truher/power-logger/README.md

# Power Logger

Multichannel logger for residential power consumption measurement.
Reads two legs of 120v and a whole log of inductive current measurements.
Uses interrupts on the Teensy to avoid phase error.
