truher/power-logger/hardware/megamon-sch.png

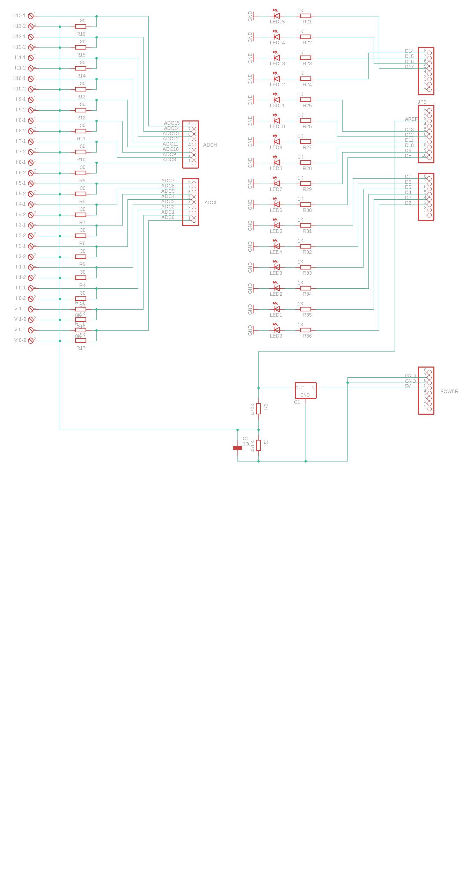
hardware/megamon-sch.png
