truher/power-logger/hardware/teensy/teensy.csv

Id | Designator | Package | Quantity | Designation | Supplier and ref
1 | U1 | Teensy35_36_EMON | 1 | Teensy3.5
2 | R40,R39,R38,R37,R36,R35,R34,R33,R32,R31,R30,R29,R28,R27,R26,R25,R24,R23 | AXIAL-0.3 | 18 | 20K
3 | J6,J5 | 1X02 | 2 | ~
4 | J4,J3,J2,J1 | 1X08 | 4 | ~
5 | RV18,RV17 | Potentiometer_Bourns_3296W_Vertical | 2 | 100K
6 | RV16,RV15,RV14,RV13,RV12,RV11,RV10,RV9,RV8,RV7,RV6,RV5,RV4,RV3,RV2,RV1 | Potentiometer_Bourns_3296W_Vertical | 16 | 200
7 | R18,R17 | AXIAL-0.3 | 2 | 100K
8 | D36,D35,D34,D33,D32,D31,D30,D29,D28,D27,D26,D25,D24,D23,D22,D21,D20,D19,D18,D17,D16,D15,D14,D13,D12,D11,D10,D9,D8,D7,D6,D5,D4,D3,D2,D1 | D_SOD-123 | 36 | ~
