truher/power-logger/hardware/teensy/teensy.kicad_pcb

## KiCad design hardware/teensy/teensy.kicad_pcb (2020-11-08)

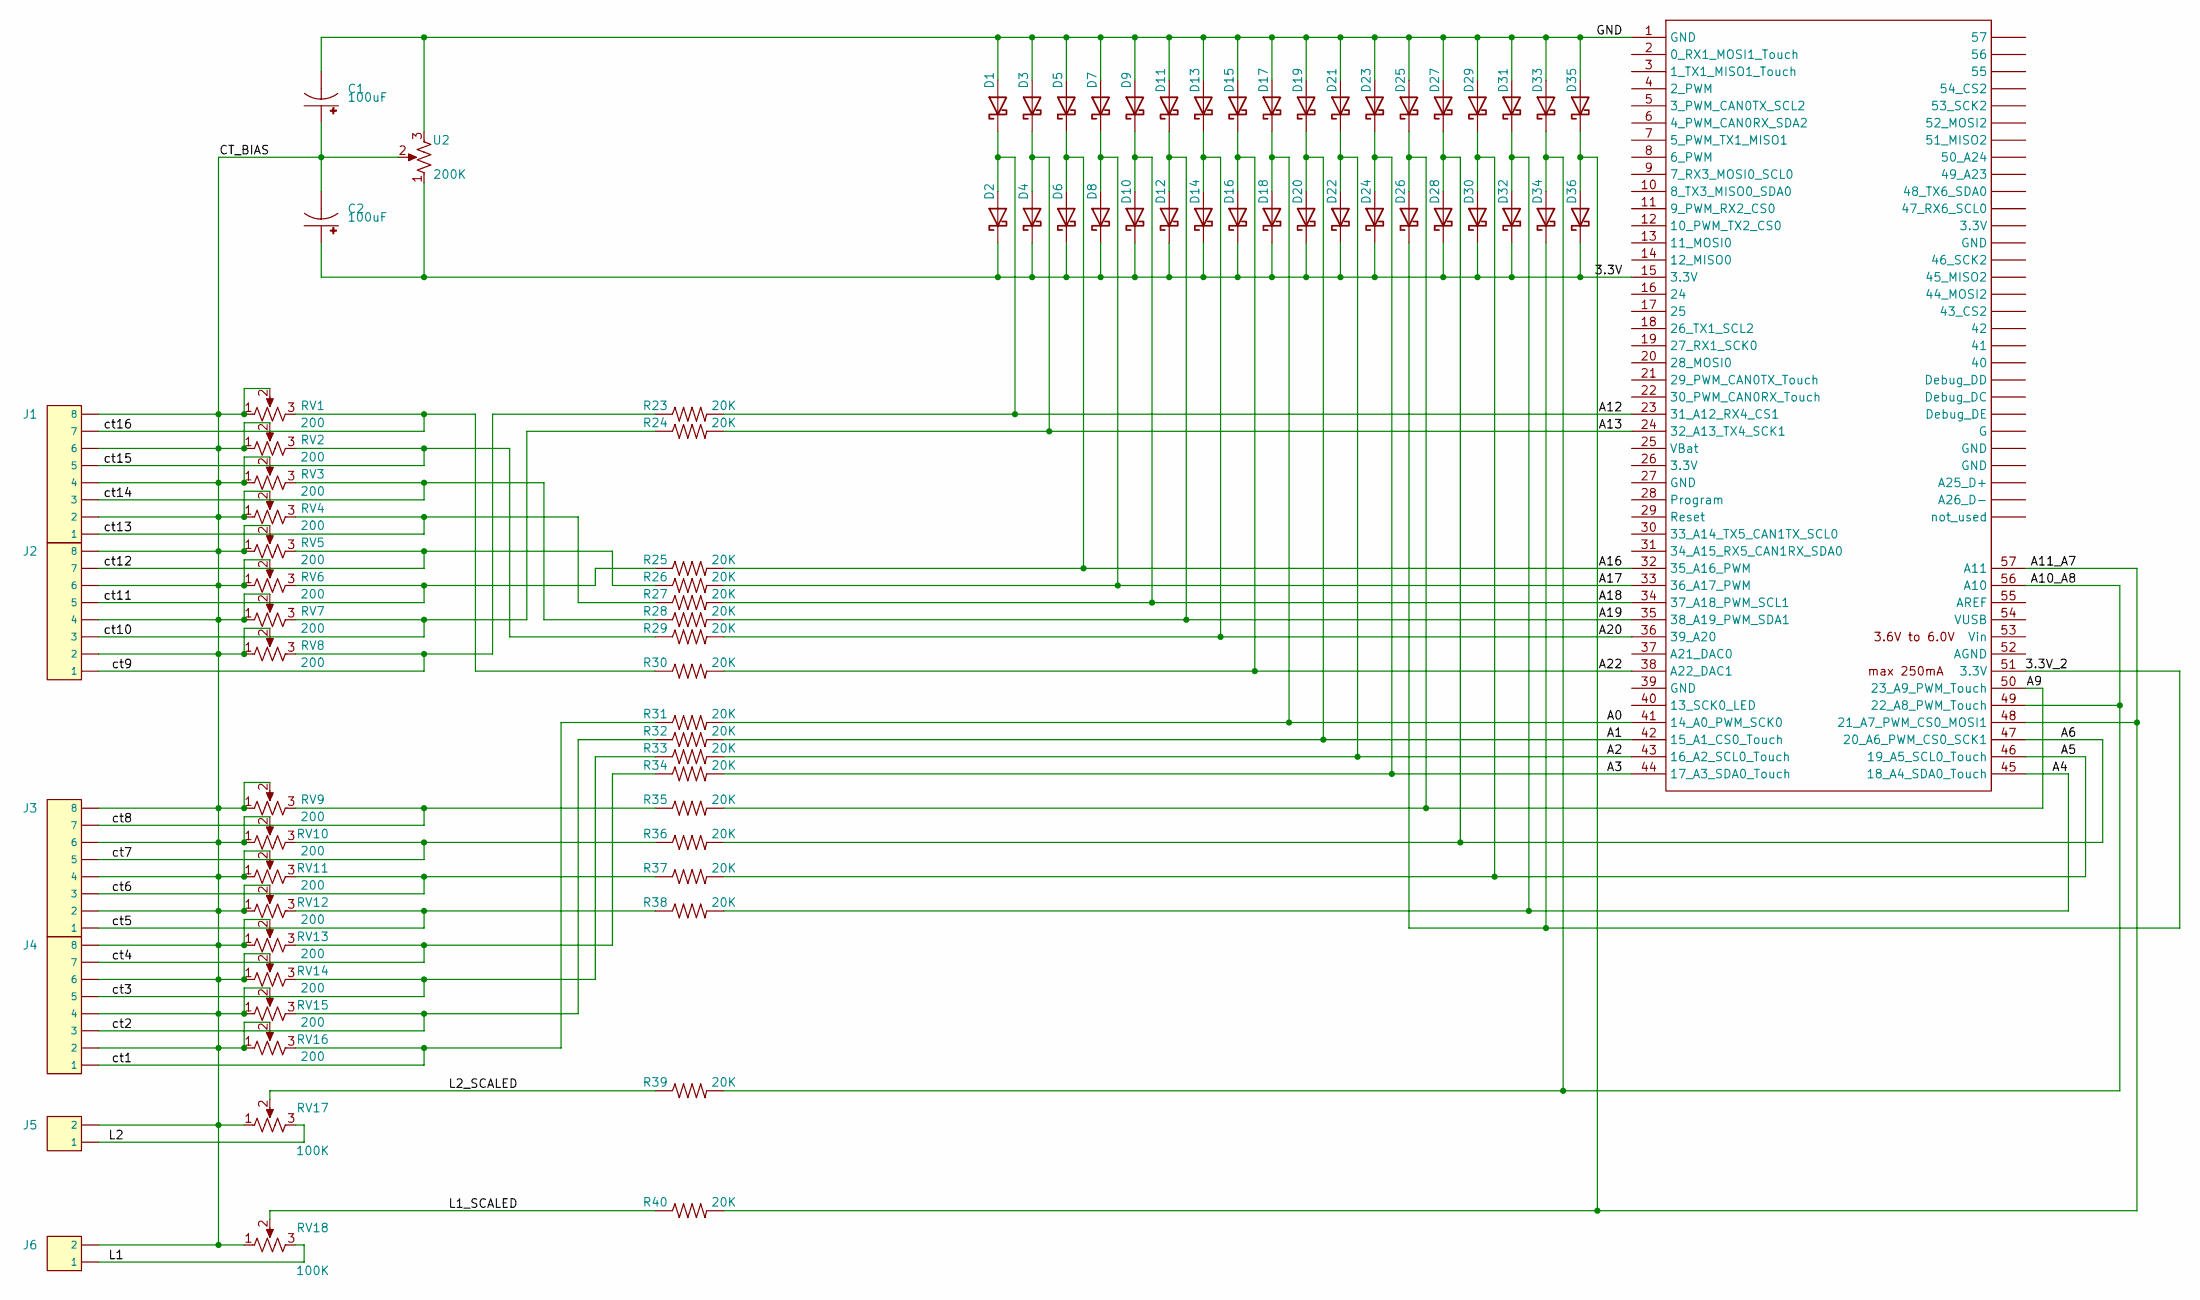
[picture p2: schematic teensy.kicad_sch]

Parts:
C1, C2: 100uF; CPOL-RADIAL-5MM-10MM
D1, D2, D3, D4, D5, D6, D7, D8, D9, D10, D11, D12, D13, D14, D15, D16, D17, D18, D19, D20, D21, D22, D23, D24, D25, D26, D27, D28, D29, D30, D31, D32, D33, D34, D35, D36: D_SOD-123
J1, J2, J3, J4: 1X08
J5, J6: 1X02
R23, R24, R25, R26, R27, R28, R29, R30, R31, R32, R33, R34, R35, R36, R37, R38, R39, R40: 20K; AXIAL-0.3
RV1, RV2, RV3, RV4, RV5, RV6, RV7, RV8, RV9, RV10, RV11, RV12, RV13, RV14, RV15, RV16: 200; Potentiometer_Bourns_3296W_Vertical
RV17, RV18: 100K; Potentiometer_Bourns_3296W_Vertical
U1: Teensy3.5; Teensy35_36_EMON
U2: 200K; Potentiometer_Bourns_3296W_Vertical

Connections:
/3.3V: C2.+, D2.1 (K), D4.1 (K), D6.1 (K), D8.1 (K), D10.1 (K), D12.1 (K), D14.1 (K), D16.1 (K), D18.1 (K), D20.1 (K), D22.1 (K), D24.1 (K), D28.1 (K), D30.1 (K), D32.1 (K), D36.1 (K), U1.15 (3.3V), U2.1
/3.3V_2: D26.1 (K), D34.1 (K), U1.51 (3.3V)
/A0: D17.1 (K), D18.2 (A), R31.P$2 (2), U1.41 (14_A0_PWM_SCK0)
/A1: D19.1 (K), D20.2 (A), R32.P$2 (2), U1.42 (15_A1_CS0_Touch)
/A2: D21.1 (K), D22.2 (A), R33.P$2 (2), U1.43 (16_A2_SCL0_Touch)
/A3: D23.1 (K), D24.2 (A), R34.P$2 (2), U1.44 (17_A3_SDA0_Touch)
/A4: D31.1 (K), D32.2 (A), R38.P$2 (2), U1.45 (18_A4_SDA0_Touch)
/A5: D29.1 (K), D30.2 (A), R37.P$2 (2), U1.46 (19_A5_SCL0_Touch)
/A6: D27.1 (K), D28.2 (A), R36.P$2 (2), U1.47 (20_A6_PWM_CS0_SCK1)
/A9: D25.1 (K), D26.2 (A), R35.P$2 (2), U1.50 (23_A9_PWM_Touch)
/A10_A8: D33.1 (K), D34.2 (A), R39.P$2 (2), U1.49 (22_A8_PWM_Touch), U1.56 (A10)
/A11_A7: D35.1 (K), D36.2 (A), R40.P$2 (2), U1.48 (21_A7_PWM_CS0_MOSI1), U1.57 (A11)
/A12: D1.1 (K), D2.2 (A), R23.P$2 (2), U1.23 (31_A12_RX4_CS1)
/A13: D3.1 (K), D4.2 (A), R24.P$2 (2), U1.24 (32_A13_TX4_SCK1)
/A16: D5.1 (K), D6.2 (A), R25.P$2 (2), U1.32 (35_A16_PWM)
/A17: D7.1 (K), D8.2 (A), R26.P$2 (2), U1.33 (36_A17_PWM)
/A18: D9.1 (K), D10.2 (A), R27.P$2 (2), U1.34 (37_A18_PWM_SCL1)
/A19: D11.1 (K), D12.2 (A), R28.P$2 (2), U1.35 (38_A19_PWM_SDA1)
/A20: D13.1 (K), D14.2 (A), R29.P$2 (2), U1.36 (39_A20)
/A22: D15.1 (K), D16.2 (A), R30.P$2 (2), U1.38 (A22_DAC1)
/CT_BIAS: C1.+, C2.-, J1.2, J1.4, J1.6, J1.8, J2.2, J2.4, J2.6, J2.8, J3.2, J3.4, J3.6, J3.8, J4.2, J4.4, J4.6, J4.8, J5.2, J6.2, RV1.1, RV1.2, RV2.1, RV2.2, RV3.1, RV3.2, RV4.1, RV4.2, RV5.1, RV5.2, RV6.1, RV6.2, RV7.1, RV7.2, RV8.1, RV8.2, RV9.1, RV9.2, RV10.1, RV10.2, RV11.1, RV11.2, RV12.1, RV12.2, RV13.1, RV13.2, RV14.1, RV14.2, RV15.1, RV15.2, RV16.1, RV16.2, RV17.1, RV18.1, U2.2
/GND: C1.-, D1.2 (A), D3.2 (A), D5.2 (A), D7.2 (A), D9.2 (A), D11.2 (A), D13.2 (A), D15.2 (A), D17.2 (A), D19.2 (A), D21.2 (A), D23.2 (A), D25.2 (A), D27.2 (A), D29.2 (A), D31.2 (A), D33.2 (A), D35.2 (A), U1.1 (GND), U2.3
/L1: J6.1, RV18.3
/L1_SCALED: R40.P$1 (1), RV18.2
/L2: J5.1, RV17.3
/L2_SCALED: R39.P$1 (1), RV17.2
/ct1: J4.1, R31.P$1 (1), RV16.3
/ct2: J4.3, R32.P$1 (1), RV15.3
/ct3: J4.5, R33.P$1 (1), RV14.3
/ct4: J4.7, R34.P$1 (1), RV13.3
/ct5: J3.1, R38.P$1 (1), RV12.3
/ct6: J3.3, R37.P$1 (1), RV11.3
/ct7: J3.5, R36.P$1 (1), RV10.3
/ct8: J3.7, R35.P$1 (1), RV9.3
/ct9: J2.1, R23.P$1 (1), RV8.3
/ct10: J2.3, R24.P$1 (1), RV7.3
/ct11: J2.5, R25.P$1 (1), RV6.3
/ct12: J2.7, R26.P$1 (1), RV5.3
/ct13: J1.1, R27.P$1 (1), RV4.3
/ct14: J1.3, R28.P$1 (1), RV3.3
/ct15: J1.5, R29.P$1 (1), RV2.3
/ct16: J1.7, R30.P$1 (1), RV1.3

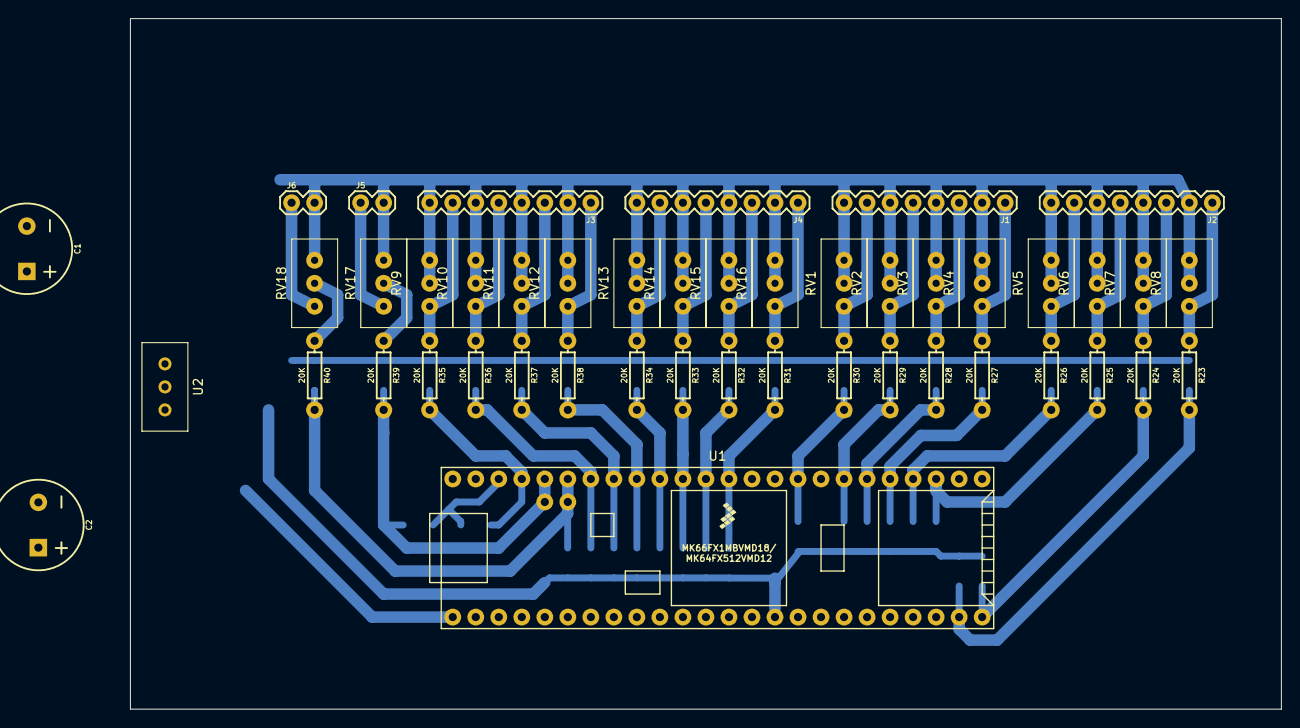
[picture p3: board teensy.kicad_pcb from above]

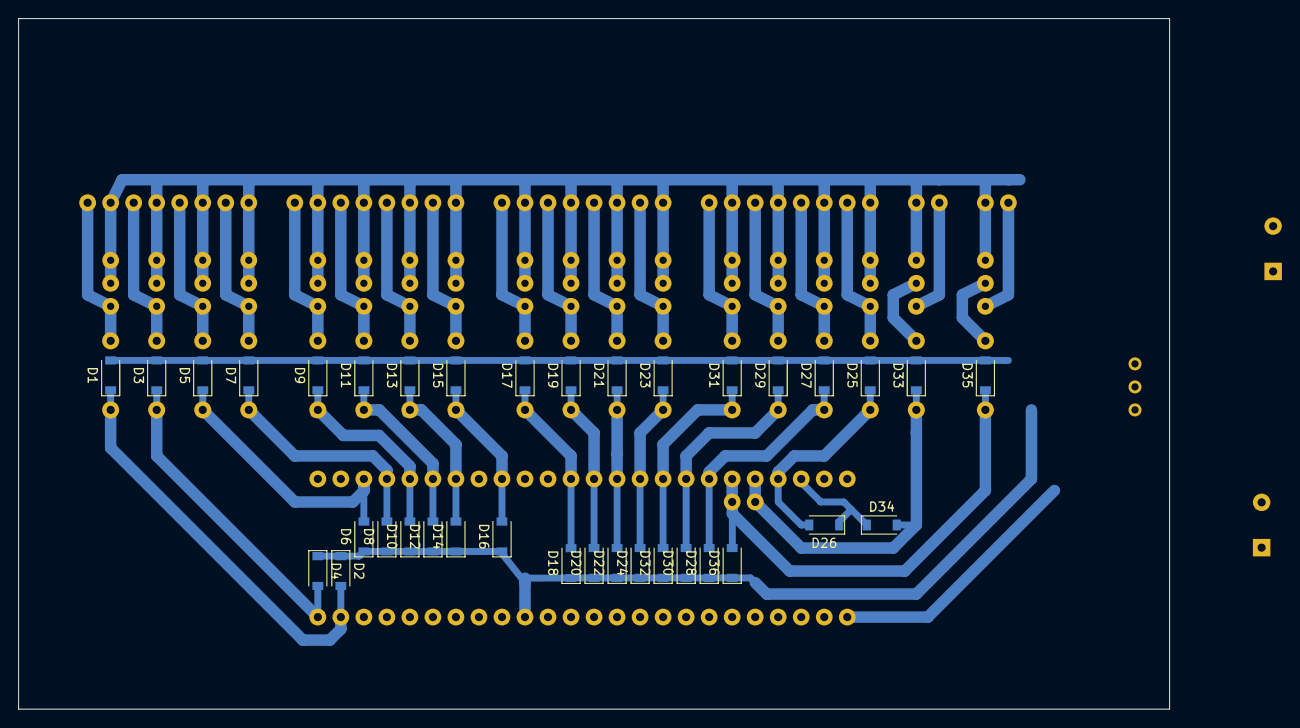
[picture p4: board teensy.kicad_pcb from below]

Board: 2 copper layers, 127.0 x 76.2 mm, 82 parts (36 on the bottom side), 42 nets.
