truher/power-logger/hardware/megamon.brd

## EAGLE design hardware/megamon.brd (2020-06-10)

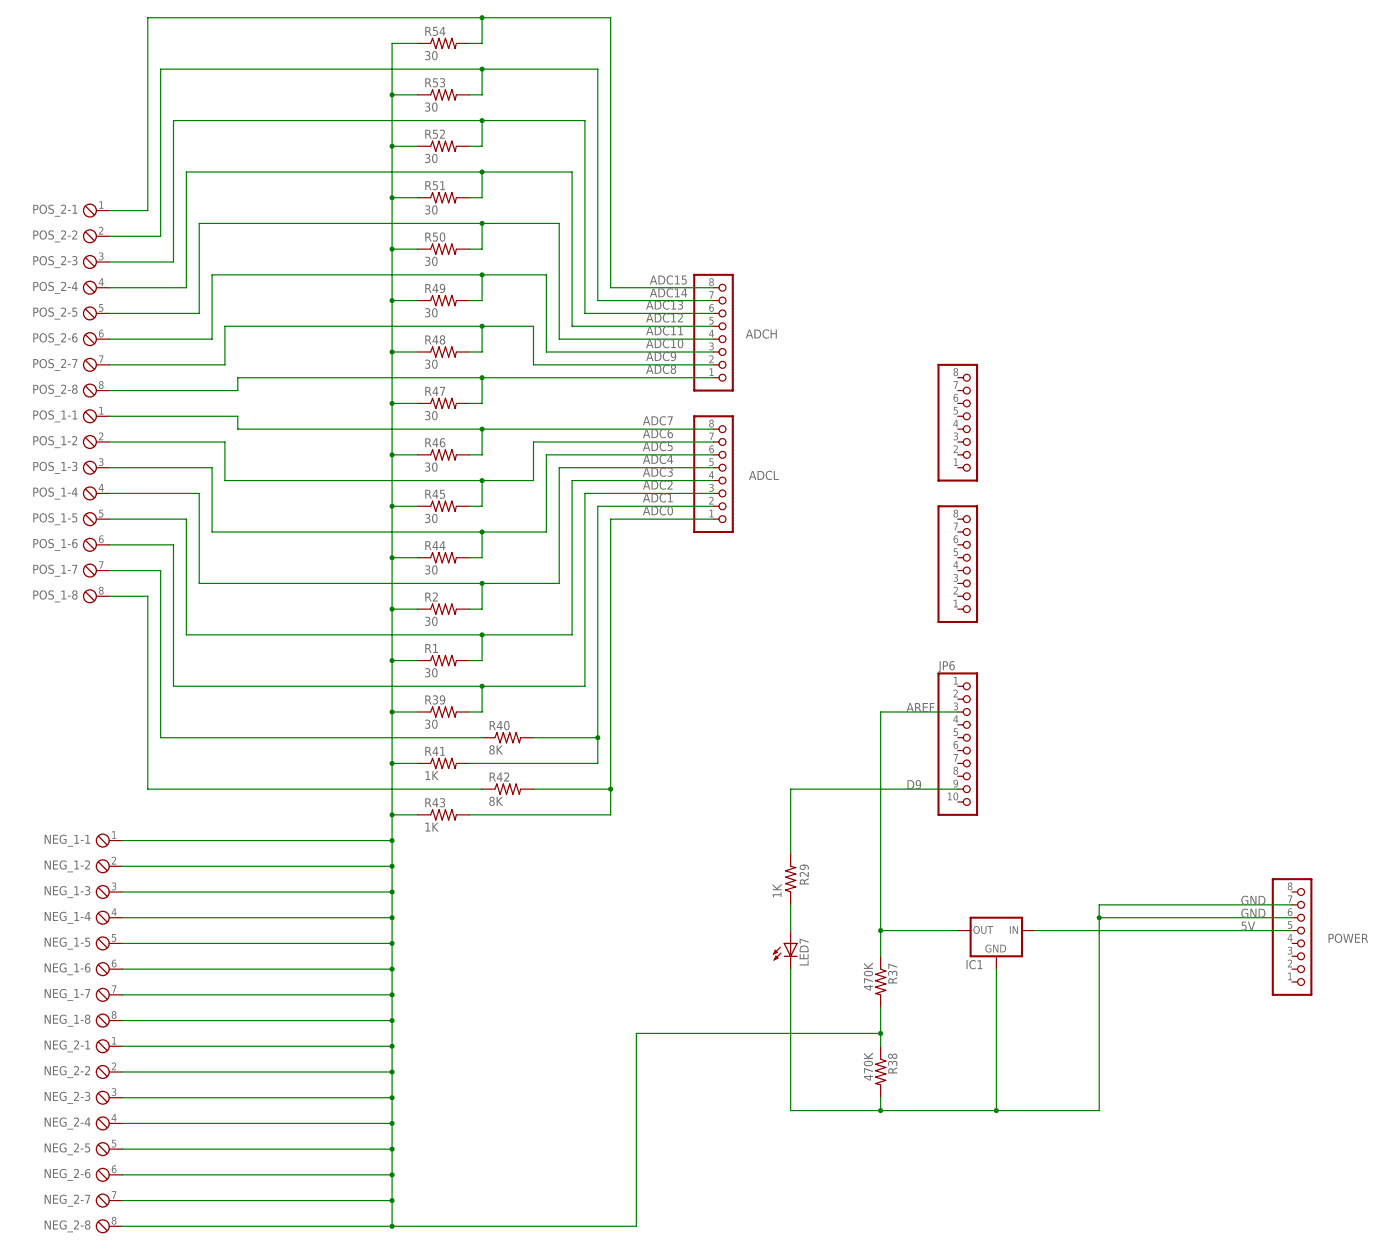
[picture p5: schematic megamon.sch]

Parts:
ADCH: PINHD-1X8; 1X08
ADCL: PINHD-1X8; 1X08
COMMUNICATION: FH254-108DF08500V; 1X08
IC1: MCP1700INLINE; TO92-INLINE
JP6: FH254-110DF08500V; 1X10
LED7: green; LED3MM
NEG_1, NEG_2: MPT8; 8POL254
POS_1, POS_2: MPT8; 8POL254
POWER: PINHD-1X8; 1X08
PWML: FH254-108DF08500V; 1X08
R1, R2, R39, R44, R45, R46, R47, R48, R49, R50, R51, R52, R53, R54: 30; 0204/7
R29, R41, R43: 1K; 0204/7
R37, R38: 470K; 0204/7
R40, R42: 8K; 0204/7

Connections:
5V: IC1.2 (IN), POWER.5
ADC0: ADCL.1, R42.2, R43.2
ADC1: ADCL.2, R40.2, R41.2
ADC2: ADCL.3, POS_1.6, R39.2
ADC3: ADCL.4, POS_1.5, R1.2
ADC4: ADCL.5, POS_1.4, R2.2
ADC5: ADCL.6, POS_1.3, R44.2
ADC6: ADCL.7, POS_1.2, R45.2
ADC7: ADCL.8, POS_1.1, R46.2
ADC8: ADCH.1, POS_2.8, R47.2
ADC9: ADCH.2, POS_2.7, R48.2
ADC10: ADCH.3, POS_2.6, R49.2
ADC11: ADCH.4, POS_2.5, R50.2
ADC12: ADCH.5, POS_2.4, R51.2
ADC13: ADCH.6, POS_2.3, R52.2
ADC14: ADCH.7, POS_2.2, R53.2
ADC15: ADCH.8, POS_2.1, R54.2
AREF: IC1.3 (OUT), JP6.3, R37.1
D9: JP6.9, R29.2
GND: IC1.1 (GND), LED7.K (C), POWER.6, POWER.7, R38.2
unnamed: POS_1.7, R40.1
unnamed: POS_1.8, R42.1
unnamed: LED7.A, R29.1
V_MID: NEG_1.1, NEG_1.2, NEG_1.3, NEG_1.4, NEG_1.5, NEG_1.6, NEG_1.7, NEG_1.8, NEG_2.1, NEG_2.2, NEG_2.3, NEG_2.4, NEG_2.5, NEG_2.6, NEG_2.7, NEG_2.8, R1.1, R2.1, R37.2, R38.1, R39.1, R41.1, R43.1, R44.1, R45.1, R46.1, R47.1, R48.1, R49.1, R50.1, R51.1, R52.1, R53.1, R54.1

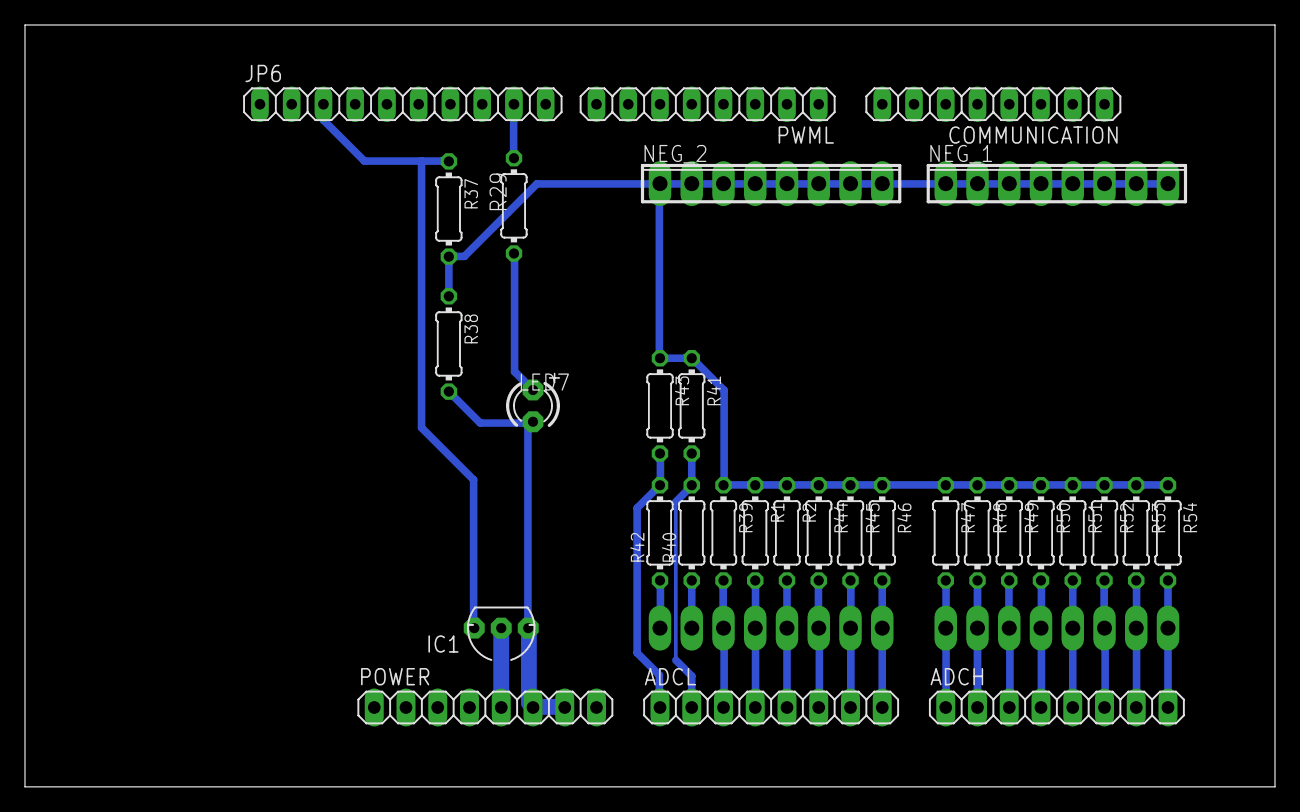
[picture p6: board megamon.brd from above]

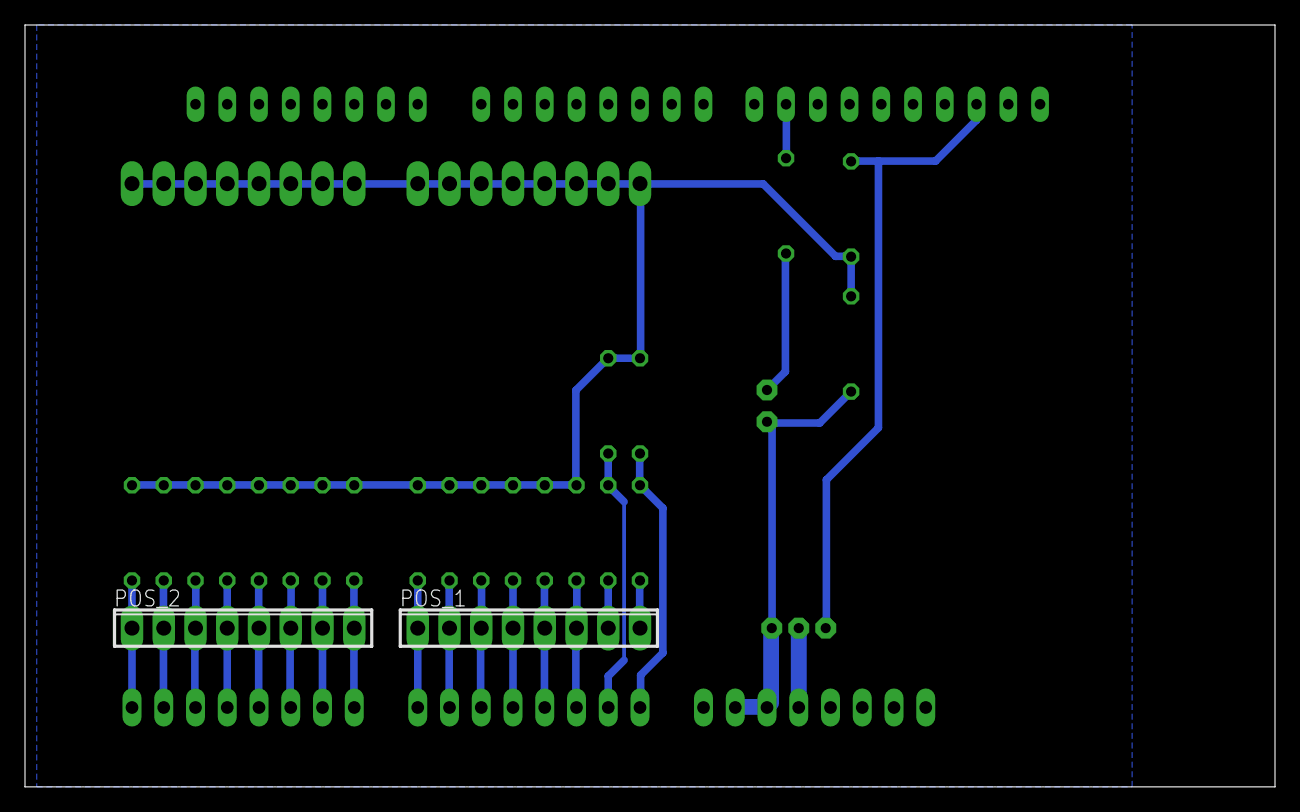
[picture p7: board megamon.brd from below]

Board: 2 copper layers, 100.0 x 61.0 mm, 33 parts (2 on the bottom side), 24 nets.
