truher/power-logger/(commit log)

2020-04-16 commit experiments
    [data.csv]
2020-04-17 rename test data file
    [data_test.csv]
2020-04-17 multiple threads, one frame? nah.
2020-04-17 add multi-sensor random data
2020-04-18 add multi-sensor summarization, plot not done yet
    [test_data_multi.csv]
2020-04-18 multi sensor plot works
2020-04-18 moving stuff to lib
    [test_data_long.csv]
2020-04-19 move random data producers into standalone scripts
    [test_data.csv]
2020-04-19 remove single-sensor plotting
2020-04-21 mv to py dir
    [test_data_long.csv, test_data_multi.csv]
2020-04-22 very simple arduino now
2020-04-26 timer interrupt for sampling
    instead of running open-loop, use one of the avr timers in CTC
    mode, to interrupt exactly every 50us, so i don't have to keep
    the observation timestamps, and so can fit more observations
    in ram.
2020-04-26 hot-plug sensor usb faster
2020-04-26 put the timeout back the way it was
    the short timeout results in partial lines i don't want to deal with
    [lib.py]
2020-04-26 fix signed hex and fallthrough bugs
    [arduino.ino]
2020-05-04 cleaned up performance benchmarks
    [db1.csv, db10.csv, db100.csv]
2020-05-06 more cleanups
    [new_raw.csv]
2020-05-07 hooked up sensors to VI charts, not fully
2020-05-08 sensors now update archival data
    still messy and slow
    [test_data_long.csv, test_data_multi.csv]
2020-05-10 wrestling with d3 for awhile
    [repeat-data.csv]
2020-05-10 remove extra files
    [repeat-data.csv]
2020-05-11 three pages working
    utc still broken
    [logger.py]
2020-05-11 fix test data
    [test_data_multi.csv]
2020-05-12 add queue to transcriber
    still single thread
2020-05-12 threaded reads work
    consumer can be arbitrarily slow, but no corruption
2020-05-13 reduced cpu load by 10X, by sleeping between reads
    threaded reader was spinning faster than the sender
2020-05-15 remove demo code for sample interpolation
2020-05-15 clean up tests and test data
    [test_kwh.csv, test_vi.csv]
2020-05-15 move demos to demo repo
    [db1.csv, db10.csv, db100.csv]
2020-05-16 linted arduino, found i was overrunning sprintf
2020-05-16 stop using orjson, it doesn't work on ARM
    [logger.py]
2020-05-17 fixed everything pylint complained about
    [lib.py, logger.py, test_lib.py]
2020-05-18 was experimenting with shorter messages
    yes, overhead scales with message length.
    [lib.py]
2020-05-22 make the emontx shield LED flash :-)
2020-05-22 looking harder at V and I
    multi graphs for "raw", zero = average, etc
    [test_kwh.csv]
2020-05-23 calibration done, graphs prettier, mypy happy
2020-06-08 add mega shield schematic
    [megamon.sch]
2020-06-08 add schematic png
2020-06-09 replace ngspice components with real ones
    [megamon.sch]
2020-06-09 first cut at the board
    [megamon.brd]
2020-06-09 removed all but one LED
    [megamon.brd, megamon.sch]
2020-06-09 replace pair terminals with separate pos/neg
    [megamon.brd, megamon.sch]
2020-06-09 component placement done
    [megamon.brd]
2020-06-10 traces done, gnd plane done
    [megamon.brd]
2020-07-03 figured out FTM on teensy
2020-07-04 more progress
    FTM triggers an interrupt (to print) and both ADCs.
    when ADCs are done, they trigger an interrupt to extract the
    values.
    DMA is not started
2020-07-04 now DMA works
    so, timer -> ADC -> DMA, one buffer per USB input
2020-07-05 yay, it works now
    bunches of 1000 samples from 2 synchronized channels, yay!
2020-07-05 cleaned up, verified with scope, works great.
    two sync'ed channel ADC with DMA, sample timing uses timer,
    batch timing is not controlled.
2020-07-06 now outputs base85 from arduino
    tried decoding a few with python, works fine.
2020-07-06 oops, remove the old printing
2020-07-06 hooked up teensy to the python part
    threw out the interpolation stuff, works fine, just one ADC though.
2020-07-06 one led flash per sample, not toggled
2020-07-06 remove AVR arduino
2020-07-06 use teensy arduino
2020-07-06 starting to fix the lint
    [lib.py]
2020-07-08 partial on-the-fly configuration of ADC parameters
2020-07-12 calibrated ADC frequencies
    1khz to 150khz seems to work, single-ended.
2020-07-12 fixed sample timing
    the teensy code default is 4x averaging, so i turned that off
    now it goes about 500khz, 2us sample time, plenty of noise at
    that speed, but whatever.
    [arduino.ino]
2020-07-16 playing with kicad
    [teensy.kicad_pcb, teensy.kicad_sch]
2020-07-17 still learning kicad
    [teensy.kicad_pcb, teensy.kicad_sch]
2020-07-17 added more to sch
    [teensy.kicad_pcb, teensy.kicad_sch]
2020-07-17 more wiring
    [teensy.kicad_pcb, teensy.kicad_sch]
2020-07-18 fully routed
    ugly, but correct, i think.
    [teensy.kicad_pcb, teensy.kicad_sch]
2020-07-18 good looking board now
    [teensy.kicad_pcb, teensy.kicad_sch]
2020-07-19 sch and pcb look good, also gbr and ngc outputs
    [teensy-B_Cu.gbr, teensy-B_Mask.gbr, teensy-B_Paste.gbr, teensy-B_SilkS.gbr, teensy-Edge_Cuts.gbr, teensy-F_Cu.gbr, teensy-F_Mask.gbr, teensy-F_Paste.gbr]
2020-07-19 fiddling with pcb2gcode
    [teensy-B_Cu.gbr, teensy-B_Mask.gbr, teensy-B_Paste.gbr, teensy-B_SilkS.gbr, teensy-Edge_Cuts.gbr, teensy-F_Cu.gbr, teensy-F_Mask.gbr, teensy-F_Paste.gbr]
2020-07-21 hoo boy, adc protection and bigger terminals
    [teensy.kicad_pcb, teensy.kicad_sch]
2020-07-22 prettier traces, removed smt thing
    [teensy-smt-B_Cu.gbr, teensy-smt-B_Mask.gbr, teensy-smt-B_Paste.gbr, teensy-smt-B_SilkS.gbr, teensy-smt-Edge_Cuts.gbr, teensy-smt-F_Cu.gbr, teensy-smt-F_Mask.gbr, teensy-smt-F_Paste.gbr]
2020-07-22 a little more beauty
    [teensy.kicad_pcb]
2020-07-23 updated gbr and ngc
    [teensy-B_Cu.gbr, teensy-B_Mask.gbr, teensy-B_Paste.gbr, teensy-B_SilkS.gbr, teensy-Edge_Cuts.gbr, teensy-F_Cu.gbr, teensy-F_Mask.gbr, teensy-F_Paste.gbr]
2020-07-25 DXF files
    [teensy-B_Cu.dxf, teensy-Edge_Cuts.dxf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]
2020-07-25 add "map" file
    [teensy-drl_map.dxf]
2020-08-08 faster feed, don't wait for spindle spin up or down
2020-08-09 bigger pads, bigger mill
    [teensy.kicad_pcb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]
2020-08-09 pcb is more than 10 thou thick
2020-08-09 remove offending M6 from drill
2020-08-09 got outline working
    [teensy-B_Cu.dxf, teensy-Edge_Cuts.dxf, teensy-drl_map.dxf, teensy.kicad_pcb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]
2020-08-10 2.54 rather than 3.5mm screws, now fits in 3x5
    [teensy.kicad_pcb, teensy.kicad_sch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]
2020-08-23 removed some resistors i don't need
    [teensy.csv, teensy.kicad_pcb, teensy.kicad_sch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]
2020-08-23 moved a few traces
    [teensy.kicad_pcb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]
2020-09-07 accommodate actual 27 mil bit
    [teensy.kicad_pcb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]
2020-09-10 add tooling cutout
    [tooling.kicad_pcb, tooling.kicad_sch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]
2020-09-12 tweaks
    mostly annoyed with ragged edges; try shallower, conventional cut
    [tooling.kicad_pcb]
2020-10-05 formatting for printing
    [teensy.kicad_pcb, teensy.kicad_sch]
2020-10-12 use correct teensy ID number
    [config.py]
2020-10-12 why does DAC1_C0 crash the teensy?
    [arduino.ino]
2020-10-12 correct decode method name
    [lib.py, logger.py, test_lib.py]
2020-10-13 arduino channels now match hardware
    i changed the routing to make it easier to lay out
2020-10-14 fixed channel config
    differential was on the wrong channel, also reported on wrong output
    [arduino.ino, logger.py]
2020-10-17 ignore first few samples since they're bad
    at least the first one is. ignoring 4 makes b85 happy.
2020-10-17 add capacitor for bias smoothing
    [teensy.kicad_pcb, teensy.kicad_sch]
2020-10-24 various filtering attempts
2020-10-25 tweaking to reduce noise
    [arduino.ino]
2020-10-25 remove filtering/phase correction
2020-11-08 fix the kicad, also tuning
    [teensy.kicad_pcb, teensy.kicad_sch]
